melexis/mcm-lin-pcb/README.md

# Melexis Compact Master LIN (MCM-LIN) PCB

This project assembles the Melexis Compact Master LIN (MCM-LIN) PCB which can be used to bootload and
control the [Melexis](https://www.melexis.com) products via [Local Interconnected Network (LIN)](https://en.wikipedia.org/wiki/Local_Interconnect_Network) protocol.

The MCM-LIN is a hardware platform which is built upon the [Espressif](https://www.espressif.com/) ESP32 and provides
an easy to use evaluation setup for the Melexis LIN products.



To explore the schematic and layout one can clone this repository and install KiCad or use [KiCanvas](https://kicanvas.org/?github=https%3A%2F%2Fgithub.com%2Fmelexis%2Fmcm-lin-pcb).

## Contributing

This is an open source project and we are very happy to accept community contributions.

## Issues and New Features

In case you have any problems with usage of the PCB, please open an issue on [Github](https://github.com/melexis/mcm-lin-pcb/issues).
Provide as much valid information as possible, as this will help us to resolve Issues faster. We would also like to hear your
suggestions about new features which would improve your MCM experiences.

## Licensing

See the [LICENSE](https://github.com/melexis/mcm-lin-pcb/blob/main/LICENSE) file for licensing information.
