melexis/mcm-lin-pcb/fabrication/CHANGELOG.md

# Changelog

## Version 1.0

* First prototype version

## Version 1.1

* Rotate LIN output connector to have consistent GND location in comparison with MCM-81339
* Add WEEE symbol in silkscreen
* Add ESD symbol in silkscreen
* Correct U5/7/8 and D4/5/15/16/17 order code in schematic

## Version 1.2

* Add power jack voltage range and polarity in silkscreen
