melexis/mcm-lin-pcb/(commit log)

2025-08-08 first version
    [MCM-LIN-MCM.kicad_sch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]
2025-09-12 add readme and move in lfs
    [MCM-LIN_bom_v1_0.ods]
2025-09-25 rotate J4 to align with others, add ESD and WEEE symbols
    [MCM-LIN-B_Cu.gbr, MCM-LIN-B_Mask.gbr, MCM-LIN-B_Silkscreen.gbr, MCM-LIN-Edge_Cuts.gbr, MCM-LIN-F_Cu.gbr, MCM-LIN-F_Mask.gbr, MCM-LIN-F_Paste.gbr, MCM-LIN-NPTH.drl]
2025-10-21 add schematic in pdf format
2025-10-21 add power jack info in silk
    [MCM-LIN.kicad_pcb]
2025-10-22 add more pick and place filetypes
    [MCM-LIN-bottom-pos.csv, MCM-LIN-pnp_bottom.gbr, MCM-LIN-pnp_top.gbr, MCM-LIN-top-pos.csv]
2025-10-22 add production files
    [MCM-LIN-B_Cu.gbr, MCM-LIN-B_Mask.gbr, MCM-LIN-B_Silkscreen.gbr, MCM-LIN-Edge_Cuts.gbr, MCM-LIN-F_Cu.gbr, MCM-LIN-F_Mask.gbr, MCM-LIN-F_Paste.gbr, MCM-LIN-NPTH.drl]
2026-11-10 update gnd connection components inline vn7040 UM1922
